vintagechips/mp_oscillo/README.md

# mp_oscillo
Minimal parts Oscilloscope<br>
Hardware information such as schematics or parts list can be found in the mp_oscillo_handling_manual.pdf. Sorry, but the explanation is written in Japanese.
