vintagechips/mp_oscillo/oscillo18313.X/system.h

#ifndef SYSTEM_H
#define	SYSTEM_H

#include <xc.h>
#include <stdint.h>

#define _XTAL_FREQ 32000000UL
#define SAMPLE 192
#define SCREEN 96
#define _I2C_FREQ 400000UL
#define OLED_ADRS 0x78

extern uint8_t adv[SAMPLE];
extern uint8_t max;
extern uint8_t min;
extern uint8_t pos;
extern uint8_t us;
extern uint8_t pod;

extern const uint8_t font[];
extern const uint8_t kigo[];

void adc_init(void);
void adc_sweep(void);
void adc_test(void);
void adc_analyze(void);

void i2c_init(void);
void i2c_start(void);
void i2c_stop(void);
void i2c_write(uint8_t);
void oled_init(void);
void oled_putch(uint8_t);
void oled_putn(uint16_t);
void oled_label(void);
void oled_draw(void);

// CONFIG1
#pragma config FEXTOSC = OFF    // FEXTOSC External Oscillator mode Selection bits (Oscillator not enabled)
#pragma config RSTOSC = HFINT32 // Power-up default value for COSC bits (HFINTOSC with 2x PLL (32MHz))
#pragma config CLKOUTEN = OFF   // Clock Out Enable bit (CLKOUT function is disabled; I/O or oscillator function on OSC2)
#pragma config CSWEN = ON       // Clock Switch Enable bit (Writing to NOSC and NDIV is allowed)
#pragma config FCMEN = ON       // Fail-Safe Clock Monitor Enable (Fail-Safe Clock Monitor is enabled)

// CONFIG2
#pragma config MCLRE = ON       // Master Clear Enable bit (MCLR/VPP pin function is MCLR; Weak pull-up enabled)
#pragma config PWRTE = OFF      // Power-up Timer Enable bit (PWRT disabled)
#pragma config WDTE = OFF       // Watchdog Timer Enable bits (WDT disabled; SWDTEN is ignored)
#pragma config LPBOREN = OFF    // Low-power BOR enable bit (ULPBOR disabled)
#pragma config BOREN = ON       // Brown-out Reset Enable bits (Brown-out Reset enabled, SBOREN bit ignored)
#pragma config BORV = LOW       // Brown-out Reset Voltage selection bit (Brown-out voltage (Vbor) set to 2.45V)
#pragma config PPS1WAY = ON     // PPSLOCK bit One-Way Set Enable bit (The PPSLOCK bit can be cleared and set only once; PPS registers remain locked after one clear/set cycle)
#pragma config STVREN = ON      // Stack Overflow/Underflow Reset Enable bit (Stack Overflow or Underflow will cause a Reset)
#pragma config DEBUG = OFF      // Debugger enable bit (Background debugger disabled)

// CONFIG3
#pragma config WRT = OFF        // User NVM self-write protection bits (Write protection off)
#pragma config LVP = ON         // Low Voltage Programming Enable bit (Low Voltage programming enabled. MCLR/VPP pin function is MCLR. MCLRE configuration bit is ignored.)

// CONFIG4
#pragma config CP = OFF         // User NVM Program Memory Code Protection bit (User NVM code protection disabled)
#pragma config CPD = OFF        // Data NVM Memory Code Protection bit (Data NVM code protection disabled)

#endif	/* XC_HEADER_TEMPLATE_H */
